jowi24/qi-pad-halter/qi-pad-halter-passtest.stl

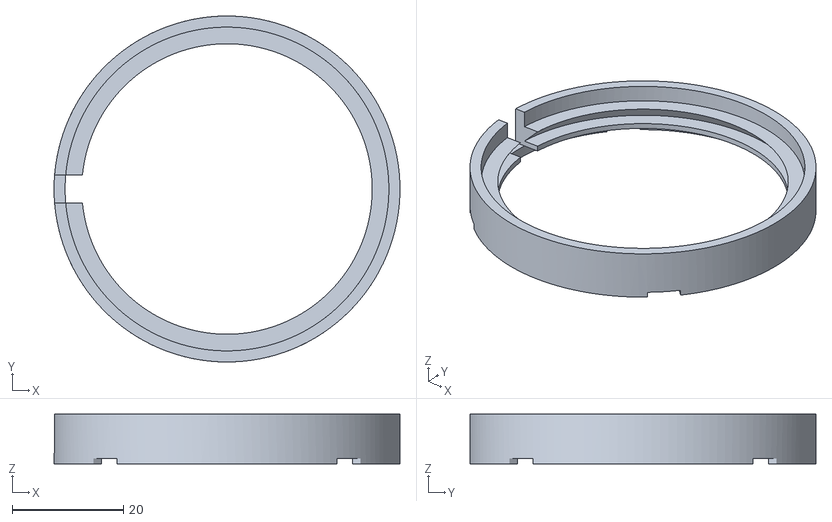
[picture p2: CAD file, 2026-10-29]
qi-pad-halter-passtest.stl
62.3 x 62.3 x 9.00
