jowi24/qi-pad-halter/qi-pad-halter.FCStd

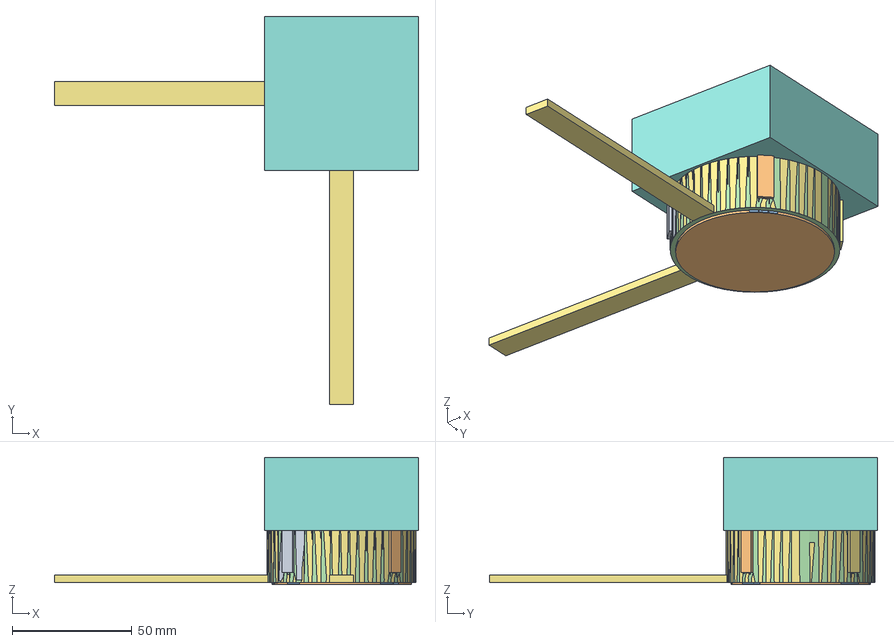
[picture p3: CAD file, 2026-10-29]
qi-pad-halter.FCStd
152.2 x 162.2 x 53.2 mm
Aussen
BohrungUnten
Mitte
PadAufnahme
Kabel
Fase
Schlitz0
Schlitz1
Schlitz2
Schlitz3
Ausschnitte
Roehre
StegLinks
StegVorne
QiPadHalter
PasstestBereich
Passtest
