jowi24/qi-pad-halter/(list of files, cad)

Other CAD files:
qi-pad-halter.stl
