jowi24/qi-pad-halter/(commit log)

2026-10-29 Qi-Pad-Halter: FreeCAD-Modell, STL, Skript, Cura-Profil (CC BY-NC 4.0)
    [qi-pad-halter-passtest.stl, qi-pad-halter.FCStd, qi-pad-halter.stl]
2026-10-29 README: passendes Produkt (EVOline Qi-Lader / PowerOrganiser) ergänzt
